Mellondawg/raspberry-pic-gopack/GoPack v2.0 - Pi 3 Simulink r2017b/README.md

# RaspberryPIC GoPack

The GoPack is a universal control/driver pack meant for rapid prototyping of mechatronic systems. 
It houses a **Raspberry Pi Version 3 Model B**, 16 bit dsPIC33F microcontroller, and has various analog and digital inputs and outputs. Programming the GoPack is done in **MATLAB Simulink version 2017b**, and sent wirelessly through the WLAN to the Raspberry Pi.

Last updated: 12/04/2017

## Raspberry Pi Setup: 

### 1) Installing support packages: (for starting from scratch)
The RaspberryPi boots off of an SD card with the MATLAB Support Package and operating system installed.  The MATLAB support packages are downloaded in MATLAB, and written to the Pi with a USB SD reader/writer. All remaining programming is done over wifi. The package can be found in MATLAB under the Add-Ons drop-down. Choose install from internet, choose Raspberry Pi, check all packages available for Pi, and follow the instructions. You will be guided to install your micro SD card in the USB card reader, and install the Rapberry Pi OS “Raspbian” with Matlab support packages for the appropriate Pi model. The latest version of GoPack uses Pi 3 Model B. 

When installing the Raspbian image onto the SD Card, if you follow the MATLAB Hardware Support walkthrough all the way through, then you can set up WiFi and SSH access. The Pi 3 Model B has built-in WiFi capabilities. The SSH access has pi as the user and raspberry as the default password.

This requires booting the Pi up, which is done by inserting the SD card that contains the Raspbian OS, connecting any additional peripherals (none required), and plugging in a micro USB power source.

Make note of the IP address that was assigned to the Pi 3.

### 2) Connecting to Pi with SSH from the main computer: 
Now on the PC, you need to be able to log in via SSH to have access to the Pi command prompt over the WLAN. Here you can download an executable called “Putty” to do so. http://www.chiark.greenend.org.uk/~sgtatham/putty/download.html
Save the executable in an accessible location, you will use it frequently. 
Run Putty. Click connection on the tree, and change “Seconds between keepalives” to 30 in order to keep the connection from timing out. Click Session in the tree, type in the IP address, highlight defaulty and save. You can now click open, and it will save the IP for next time. If you get a security alert, click yes. The default username and password are pi and raspberry (note the password will not show in the command window). 

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

### 3) Installing GPIO Interface Library wiringPi
The driver blocks used for PWM, ADC and Encoder inputs use the library called wiringPi www.wiringpi.com. To install wiringPi, git must first be installed. The standard image that MATLAB uses for Pi 3 already contains git.

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

`sudo apt-get install git-core`

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

`git clone https://github.com/UMass-MRRL/wiringPi-GoPack.git`

Note: If you download wiringPi from its original source (git://git.drogon.net/wiringPi), that’s the wrong version. If updating wiringPi, type:
```
cd wiringPi-GoPack
git pull origin
```
Note: You must move the items within the wiringPi-GoPack directory that is created, up one level. Meaning the contents of the wiringPi-GoPack must be moved to the level where the wiringPi-GoPack directory is. This can be done by:

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

Shutting the Pi down:
When connected with SSH via Putty, type this to shut down safely.  

`sudo halt`

Click OK when Putty gives a fatal error, it thinks the connection has failed. Close Putty. 

## Interfacing the Raspberry Pi with the GoPack add-on board

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

## Using GoPack with MATLAB and Simulink

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

### 2) Using GoPack s-Functions to handle sensors and actuators
It is recommended that you familiarize yourself with the basics:
http://www.mathworks.com/help/supportpkg/raspberrypi/examples/getting-started-with-raspberry-pi-hardware.html

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

## Additional Information

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

Additionally, if the S-Function builder of Simulink is unable to detect the supported compiler that is being used, please ccheck out this MATLAB Answers link, which details how entering these two commands should help (they only have to be entered once, not every time you run the model): 
```
>> rtwMKCFG_out=rtwmakecfg
>> mex(['-I' rtwMKCFG_out.includePath{:}], ['-I' rtwMKCFG_out.sourcePath{:}], ['-L' rtwMKCFG_out.linkLibsObjs{:}], 'yourSFunctionName.c', 'yourSFunctionName_wrapper.c', '-lfixedpoint')
```
https://www.mathworks.com/matlabcentral/answers/92279-why-do-i-get-an-error-when-i-use-the-s-function-builder-in-64-bit-simulink-with-the-windows-sdk-7-1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

htop: http://hisham.hm/htop/
An interactive process viewer for Unix that can show core utilization.

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
