Mellondawg/raspberry-pic-gopack/GoPack v2.0 - Pi 3 Simulink r2017b/GoPack Board Rev B/GoPack2 Parts List.xlsx

GoPack Rev B
Item | Vendor | Manufacturer P/N | Digikey P/N | Qty per board | Price/Unit | Price
PCB (x3 with shipping) | OshPark | RaspberryPIC GoPack REV B |  | 1 | $66.3500 | $22.12
IC OPAMP VFB 130MHZ RRO 14TSSOP | Digikey | LMH6644MTX/NOPB | LMH6644MTX/NOPBCT-ND | 3 | $2.1900 | $6.57
UA9637AC Dual line receiver | Digikey | UA9637ACDR | 296-15056-1-ND | 1 | $0.8510 | $0.85
MC3486D Quad line receiver | Digikey | MC3486DR | 296-14624-1-ND | 1 | $0.8510 | $0.85
dsPIC33 Microcontroller, 44pin QFP | Digikey | DSPIC33FJ64MC204 | DSPIC33FJ64MC204-E/PT-ND | 1 | $5.1300 | $5.13
LM25011 Switching regulator | Digikey | LM25011MY/NOPB | LM25011MY/NOPBCT-ND | 1 | $2.3340 | $2.33
LM1117 3V3 Linear regulator | Digikey | LM1117IMPX-3.3/NOPB | LM1117IMPX-3.3/NOPBCT-ND | 1 | $0.9270 | $0.93
LM1117 5V Linear regulator | Digikey | LM1117IMPX-5/NOPB | LM1117IMPX-5.0/NOPBCT-ND | 1 | $0.9270 | $0.93
CDRH8D38 Inductor coil | Digikey | CDRH8D38NP-220NC | 308-1593-1-ND | 1 | $0.9300 | $0.93
B340A Schottky diode | Digikey | B340A-13-F | B340A-FDICT-ND | 1 | $0.3390 | $0.34
Yellow LED | Digikey | LTST-C190KSKT | 160-1437-1-ND | 1 | $0.2110 | $0.21
Green LED | Digikey | LTST-S270GKT | 160-1475-1-ND | 1 | $0.1950 | $0.20
RGB LED | Digikey | LTST-C19HE1WT | 160-2162-1-ND | 1 | $0.4240 | $0.42
0603 0.1uF capacitor 50V | Digikey | CC0603ZRY5V9BB104 | 311-1343-1-ND | 5 | $0.0082 | $0.04
0603 0.47 uF capacitor | Digikey | C0603C474K4RACTU | 399-4922-1-ND | 3 | $0.0576 | $0.17
0603 0.022 uF capacitor 25V | Digikey | CL10B223KA8NNWC | 1276-2000-1-ND | 1 | $0.0214 | $0.02
0805 10 uF capacitor | Digikey | 0805YD106KAT2A | 478-5165-1-ND | 3 | $0.0756 | $0.23
1206 10 uF capacitor | Digikey | CC1206ZKY5V7BB106 | 311-1376-1-ND | 2 | $0.0790 | $0.16
1210 4.7 uF capacitor | Digikey | GRM32ER71K475KE14L | 490-9972-1-ND | 1 | $0.7190 | $0.72
5mm pitch radial 100 uF capacitor 160V | Digikey | UCY2C101MHD1TO | 493-4784-1-ND | 2 | $1.2400 | $2.48
0603 1k resistor | Digikey | RC0603JR-071KL | 311-1.0KGRCT-ND | 2 | $0.0044 | $0.01
0603 470 resistor | Digikey | RC0603JR-07470RL | 311-470GRCT-ND | 2 | $0.0040 | $0.01
0603 4.7k resistor | Digikey | RC0603FR-074K7L | 311-4.70KHRCT-ND | 1 | $0.0052 | $0.01
0603 3k resistor | Digikey | RC0603FR-073KL | 311-3.00KHRCT-ND | 1 | $0.0052 | $0.01
0603 0.08 resistor | Digikey | ERJ-3BWFR082V | P17476CT-ND | 1 | $0.2760 | $0.28
0603 390 resistor | Digikey | RC0603JR-07390RL | 311-390GRCT-ND | 1 | $0.0040 | $0.004
0805 10k resistor | Digikey | CRCW080510K0JNEA | 541-10KACT-ND | 1 | $0.0109 | $0.01
0805 240k resistor | Digikey | RC0805FR-07240KL | 311-240KCRCT-ND | 1 | $0.0077 | $0.01
50k SMT potentiometer | Digikey | ST32ETA503 | ST32ETA503CT-ND | 6 | $1.1388 | $6.83
2x18 Pin header (choose 2x40) | Digikey | PRPC040DAAN-RC | S2011EC-40-ND | 1 | $1.3160 | $1.32
1x5 Pin header (choose 1x40) | Digikey | PRPC040SAAN-RC | S1011EC-40-ND | 1 | $0.7400 | $0.74
2x20 Female Pin header | Digikey | PPTC202LFBN-RC | S6104-ND | 1 | $2.7300 | $2.73
10A 125VDC power switch | Digikey | PB1973GBLKGILEF4 | PB1973GBLKGILEF4-ND | 1 | $1.6000 | $1.60
0.187" (4.75mm) Quick Connect Female 18-22 AWG | Digikey | 2-520193-2 | A27806CT-ND | 2 | $0.2730 | $0.55
0603 1.2k resistor | Digikey | RT0603DRE071K2L | 311-2461-1-ND | 3 | $0.0426 | $0.13
0603 33k resistor | Digikey | RC0402FR-070RL | 311-0.0LRCT-ND | 6 | $0.0050 | $0.03
0603 47 pF capacitor | Digikey | CBR06C470JAGAC | 399-6191-1-ND | 3 | $0.1590 | $0.48
0603 100 pF capacitor | Digikey | C0402C101J3GACTU | 399-1022-1-ND | 3 | $0.0160 | $0.05
TVS DIODE 54V 87.1V DO214AA | Digikey | SMBJ54A-E3/52 | SMBJ54A-E3/52GICT-ND | 1 | $0.2000 | $0.20
FUSE BRD MNT 4A 125VAC/VDC 2SMD | Digikey | 0157004.DR | F2968CT-ND | 1 | $1.5800 | $1.58
FIXED IND 22UH 4A 39.1 MOHM SMD | Digikey | DR127-220-R | 513-1044-1-ND | 3 | $1.2800 | $3.84
Screw Terminals 5mm Pitch (2-Pin) | Digikey | 282836-2 | A98076-ND | 2 | $0.3300 | $0.66
Screw Terminals 5mm Pitch (6-Pin) | Digikey | 1792902 | 277-2522-ND | 1 | $0.8600 | $0.86
Screw Terminals 5mm Pitch (11-Pin) | Digikey | 1792957 | 277-2527-ND | 1 | $1.4400 | $1.44
9 Position Socket Connector 0.100" (2.54mm) Through Hole Gold | Digikey | 801-87-009-10-001101 | 1212-1193-ND | 2 | $0.6000 | $1.20
11 Position Socket Connector 0.100" (2.54mm) Through Hole Gold | Digikey | 801-87-011-10-001101 | 1212-1198-ND | 1 | $0.7150 | $0.71
 |  |  |  |  | Total: | $70.89
Based on cut-tape packaging, ~100 qty price break for most passives
The motor module that we have designed for is:
ESCON Module 50/5, 4-Q Servocontroller for DC/EC motors, 5/15 A, 10 - 50 VDC
https://www.maxonmotor.com/maxon/view/product/control/4-Q-Servokontroller/438725
