Mellondawg/raspberry-pic-gopack/(commit log)

2018-01-17 Added switch model
2018-05-03 Final commit containing switching
2018-05-03 Added New Board Files
2018-05-03 Adding Board Files
    [GoPack Parts List.xlsx, GoPack2 Parts List.xlsx, Pi MCU shield 2.brd, Pi MCU shield 2.sch, Pi MCU shield.brd]
2018-05-04 Added more accurate pricing
    [GoPack2 Parts List.xlsx]
2018-05-04 Added link to motor module
    [GoPack2 Parts List.xlsx]
2018-05-04 Directory name change
    [GoPack2 Parts List.xlsx, Pi MCU shield 2.brd, Pi MCU shield 2.sch]
